1Ryza1/Bewaesserung-System/README.md

# Bewaesserung-System

Zimmerpflanzen feuchtigkeit messen und automatisch gießen.

Wir brauchen
Feuchtigkeitssensor
Microcontroller
Ventil
Behälter
Schlauch
Lampe

Feuchtigkeitssensor erkennt, dass die pflanze gegossen werden muss, anhand der trockenden erde und gibt das Signal and den Microcontroller.
Der Controller öffnet das dazugehörige Ventil.

Wenn der Behälter fast leer ist, leuchtet eine Lampe um zu Signalisieren, dass wasser anchgefüllt werdne muss. Vielleicht auch per push nachricht per Telegrambot
{42C6C1D7-5769-4985-9132-D3B41F0A940E}
{FEBAC813-1F5F-44BB-ADE6-F5729D4DE113}
