1Ryza1/Bewaesserung-System/Arduino_Bewaesserung_Projektdokumentation.docx

PROJEKTDOKUMENTATION

Automatisches Arduino-
Bewässerungssystem für Pflanzen

Sensorbasierte Bewässerung mit OLED-Anzeige, Tanküberwachung,
Menüsteuerung und dauerhaft gespeicherten Statistiken

Projektgruppe | ____________________________
Klasse / Lernfeld | ____________________________
Lehrkraft | ____________________________
Datum | 22.09.2026
Stand | Funktionsfähiger Prototyp

# Inhaltsübersicht

1 Projektübersicht

2 Zielsetzung und Anforderungen

3 Hardware und Komponenten

4 Verdrahtung und Pinbelegung

5 Sensoren und Kalibrierung

6 Funktionsweise der Bewässerung

7 OLED-Menü und Bedienung

8 Statistiken und EEPROM

9 Softwareaufbau

10 Sicherheits- und Fehlerkonzept

11 Testdurchführung und Ergebnisse

12 Grenzen und Erweiterungsmöglichkeiten

13 Fazit

Anhang A Test- und Abnahmecheckliste

Anhang B Zentrale Programmparameter

# 1 Projektübersicht

Im Projekt wurde ein automatisches Bewässerungssystem für Pflanzen auf Basis eines Arduino entwickelt. Das System misst kontinuierlich die Bodenfeuchtigkeit und entscheidet selbstständig, ob gegossen werden muss. Zusätzlich wird überwacht, ob sich ausreichend Wasser im Vorratsbehälter befindet. Ein OLED-Display zeigt Messwerte, Systemstatus und Statistiken an.

Projektkern: Nicht einfach dauerhaft pumpen, sondern dosiert gießen, anschließend warten, erneut messen und nur bei Bedarf eine weitere kleine Wassermenge abgeben.

## 1.1 Aktueller Funktionsumfang

- Bodenfeuchtigkeit als Rohwert und Prozentwert erfassen.
- Bewässerung automatisch ab einem definierten Trockenheitswert starten.
- Pumpe in kurzen 5-Sekunden-Intervallen ansteuern.
- Nach jedem Pumpen 20 Sekunden warten, damit sich das Wasser im Boden verteilen kann.
- Nach der Wartezeit erneut messen und bei Bedarf weiter bewässern.
- Tankfüllstand überwachen und die Pumpe bei leerem Tank sperren.
- Warn-LED bei leerem Tank blinken lassen.
- Drei OLED-Menüseiten über einen Taster umschalten.
- Gießvorgänge, Pumpenrunden und Pumpenlaufzeit dauerhaft im EEPROM speichern.
- Sicherheitslimit von maximal fünf Pumpenrunden pro Bewässerungszyklus verwenden.

# 2 Zielsetzung und Anforderungen

Ziel war die Entwicklung eines funktionsfähigen Prototyps, der eine Pflanze möglichst selbstständig und sicher bewässert. Dabei sollten nicht nur Sensorwerte angezeigt, sondern aus diesen Werten konkrete Aktionen abgeleitet werden.

Punkt | Beschreibung
Automatik | Bewässerung soll ohne manuellen Eingriff starten, sobald die Erde zu trocken ist.
Dosierung | Die Pumpe soll nicht dauerhaft laufen, sondern nur kurze Wassermengen abgeben.
Rückkopplung | Nach dem Gießen wird der neue Bodenwert bewertet, bevor erneut gegossen wird.
Tanküberwachung | Bei leerem Wasserbehälter darf die Pumpe nicht laufen.
Bedienung | Messwerte und Statistiken sollen direkt am Gerät abrufbar sein.
Datenerhalt | Statistiken sollen nach einem Neustart weiterhin vorhanden sein.
Sicherheit | Fehlbedienung und unbegrenztes Pumpen müssen verhindert werden.

# 3 Hardware und Komponenten

Punkt | Beschreibung
Arduino-Board | Steuert Sensoren, Display, LED, Taster und Relais.
SH1106 OLED 128 × 64 | I²C-Display zur Anzeige von Messwerten, Status und Statistiken; Adresse 0x3C.
Bodenfeuchtigkeitssensor | Analoger Sensor zur Bestimmung der Bodenfeuchte; Ausgang AO an A1.
Wasserstandssensor | Analoger Sensor zur Erkennung des Wasserstands im Vorratsbehälter; an A0.
Relaismodul | Schaltet die Pumpe. Das verwendete Modul ist LOW-aktiv.
Wasserpumpe | Fördert Wasser aus dem Tank zur Pflanze.
LED | Optische Warnung bei leerem Tank.
220–330 Ω Widerstand | Vorwiderstand für die Warn-LED.
4-Pin-Taster | Wechselt zwischen den OLED-Menüseiten; elektrisch werden nur zwei gegenüberliegende Kontaktgruppen benötigt.
Schläuche / Wasserbehälter | Führen das Wasser von der Pumpe zur Pflanze.

# 4 Verdrahtung und Pinbelegung

Punkt | Beschreibung
A0 | Wasserstandssensor / Tanksensor
A1 | Bodenfeuchtigkeitssensor (AO)
A4 | OLED SDA
A5 | OLED SCL
D6 | Menü-Taster gegen GND; interner Pull-up aktiv
D7 | Warn-LED über 220–330 Ω Vorwiderstand nach GND
D8 | Relaissteuerung für die Pumpe
5 V | Versorgung der geeigneten Sensor-/OLED-Module gemäß deren Spezifikation
GND | Gemeinsame Masse aller Baugruppen

LED-Anschluss: D7 → 220–330 Ω → Anode der LED (langes Bein) → Kathode (kurzes Bein) → GND. Die LED darf nicht ohne Vorwiderstand direkt zwischen 5 V und GND betrieben werden.

Relaislogik: Das verwendete Relais ist LOW-aktiv: LOW bedeutet Pumpe EIN, HIGH bedeutet Pumpe AUS. Der Sketch setzt den Relaispin deshalb schon beim Start auf HIGH.

## 4.1 Taster mit vier Anschlüssen

Der verwendete Taster besitzt vier Pins, besteht elektrisch jedoch aus zwei Kontaktgruppen. Je zwei Pins sind intern miteinander verbunden. Für die Schaltung werden nur zwei Pins aus unterschiedlichen Kontaktgruppen benötigt. Der Taster wird zwischen D6 und GND angeschlossen. Durch INPUT_PULLUP ist kein externer Pull-up-Widerstand erforderlich.

# 5 Sensoren und Kalibrierung

## 5.1 Bodenfeuchtigkeitssensor

Der Bodenfeuchtigkeitssensor liefert einen Analogwert zwischen ungefähr 0 und 1023. Bei dem verwendeten Sensor gilt: Ein hoher Wert bedeutet trocken, ein niedriger Wert bedeutet feucht.

Messsituation | Rohwert | Interpretation
In trockenes Papier eingewickelt | ca. 1020 | knochentrocken / 0 %
Frische Blumenerde aus dem Sack | ca. 350 | deutlich feucht / Zielbereich
Sehr feuchte Erde im Test | ca. 275 | unterhalb des Zielwerts / Anzeige auf 100 % begrenzt

Für die Anzeige wird der Bereich 1020 → 0 % und 350 → 100 % linear umgerechnet. Werte unter 350 werden auf 100 % begrenzt. Die Prozentanzeige ist daher eine projektbezogene relative Feuchte und keine wissenschaftlich bestimmte volumetrische Bodenfeuchte.

## 5.2 Schaltgrenzen des Bodens

Punkt | Beschreibung
≥ 700 | Boden gilt als zu trocken; ein Bewässerungszyklus wird gestartet.
≤ 350 | Zielwert erreicht; Bewässerung wird beendet.
350–699 | Kein neuer Gießvorgang; Boden gilt als ausreichend feucht.

## 5.3 Tanksensor

Der Tanksensor liefert ebenfalls einen Analogwert. Für die aktuelle Software wird eine Hysterese verwendet: Unter 100 gilt der Tank als leer, über 200 als gefüllt. Zwischen 100 und 200 bleibt der vorherige Zustand erhalten. Dadurch flackert der Tankstatus bei schwankenden Messwerten nicht ständig hin und her.

Die Prozentanzeige des Tanks ist derzeit vorläufig mit 0 → 0 % und 500 → 100 % kalibriert. Für eine genaue Füllstandsanzeige sollten später ein echter Leerwert und ein Wert bei gewünschtem Maximalfüllstand gemessen werden.

# 6 Funktionsweise der Bewässerung

Der Kern des Systems ist eine geschlossene Regelung: Messen → dosiert gießen → warten → erneut messen. Dadurch wird vermieden, dass die Pumpe unnötig lange läuft oder der Boden in einem einzigen Schritt überwässert wird.

1. Boden- und Tankwert werden gemessen.
2. Ist der Tank leer, bleibt die Pumpe gesperrt und die Warn-LED blinkt.
3. Liegt der Bodenwert unter 700, wird nicht gegossen.
4. Liegt der Bodenwert bei 700 oder höher, startet ein Bewässerungszyklus.
5. Die Pumpe läuft 5 Sekunden.
6. Anschließend wartet das System 20 Sekunden, damit sich das Wasser verteilen kann.
7. Der Boden wird erneut gemessen.
8. Bei einem Wert über 350 wird eine weitere 5-Sekunden-Pumpenrunde ausgeführt.
9. Bei einem Wert von 350 oder kleiner wird der Zyklus beendet.
10. Nach maximal fünf Pumpenrunden wird aus Sicherheitsgründen abgebrochen.

## 6.1 Ablaufdiagramm

START
|
Sensoren messen
|
Tank leer? ---- JA ----> Pumpe AUS + LED blinkt
| NEIN
Boden >= 700? -- NEIN --> BEREIT / weiter messen
| JA
Pumpe 5 s AN
|
Pumpe AUS
|
20 s warten
|
Boden erneut messen
|
Boden <= 350? -- JA ---> Ziel erreicht / STOP
| NEIN
Max. 5 Runden erreicht? -- JA --> Sicherheitsstopp
| NEIN
+-----------------------> erneut 5 s gießen

# 7 OLED-Menü und Bedienung

Über den Taster an D6 kann während des Betriebs zwischen drei Menüseiten umgeschaltet werden. Der Taster wird softwareseitig entprellt, damit ein einzelner Tastendruck nicht mehrfach erkannt wird.

## 7.1 Seite 1 – Übersicht

Boden: 63%
Tank: 82%
Pumpe: AUS
---------------------
BEREIT

## 7.2 Seite 2 – Statistik

STATISTIK

Giessen: 4
Pumpen: 9
Laufzeit: 45s

## 7.3 Seite 3 – Rohwerte

ROHWERTE

Boden: 598
Tank: 411
Start:700 Ziel:350

# 8 Statistiken und EEPROM

Die Statistikdaten werden im EEPROM des Arduino gespeichert. Dieser Speicher behält seine Daten auch nach dem Ausschalten. Dadurch gehen die Zähler beim Trennen der Stromversorgung nicht verloren.

Punkt | Beschreibung
Gießvorgänge | Anzahl der vollständigen Bewässerungszyklen, die tatsächlich gestartet wurden.
Pumpenrunden | Anzahl einzelner Pumpenintervalle. Ein Gießvorgang kann aus mehreren Pumpenrunden bestehen.
Pumpenlaufzeit | Aufsummierte Pumpenlaufzeit in Sekunden.

Beispiel: Benötigt ein Bewässerungszyklus drei Pumpenintervalle à fünf Sekunden, erhöht sich „Gießen“ um 1, „Pumpen“ um 3 und die Laufzeit um 15 Sekunden.

EEPROM-Schonung: Die Statistik wird nicht in jeder Programmschleife geschrieben, sondern nur nach relevanten Bewässerungsereignissen. Dadurch werden unnötige Schreibzyklen vermieden.

# 9 Softwareaufbau

Der Sketch ist in einzelne Funktionen gegliedert. Dadurch können Messung, Anzeige, Pumpensteuerung und Statistik unabhängig voneinander nachvollzogen und getestet werden.

Punkt | Beschreibung
mittelwert() | Liest einen Analogeingang zehnmal und bildet einen Mittelwert zur Beruhigung der Messwerte.
bodenMessen() / tankMessen() | Aktualisieren die beiden Sensorwerte.
bodenProzent() / tankProzent() | Rechnen Rohwerte in eine 0–100-%-Anzeige um.
pumpeEin() / pumpeAus() | Kapseln die LOW-aktive Relaislogik.
ledAktualisieren() | Lässt die Warn-LED bei leerem Tank im 500-ms-Takt blinken.
buttonAktualisieren() | Entprellt den Taster und wechselt die Menüseiten.
oledAktualisieren() | Zeichnet die aktuell ausgewählte OLED-Seite.
giessen() | Führt eine einzelne Pumpenrunde von maximal fünf Sekunden aus und überwacht dabei den Tank.
wartenNachGiessen() | Wartet 20 Sekunden, misst dabei regelmäßig und hält LED/Taster weiterhin aktiv.
bewaessern() | Steuert den gesamten Regelzyklus und das Sicherheitslimit.
statistikLaden() / statistikSpeichern() | Lesen und schreiben die persistenten EEPROM-Daten.

## 9.1 Speicherschonung

Das SH1106-OLED benötigt einen großen Bildpuffer im knappen SRAM des Arduino. Eine frühere Programmversion konnte das Display deshalb nicht initialisieren. Die aktuelle Version verwendet für feste Texte das F()-Makro, damit diese Texte im Flash-Speicher statt im SRAM liegen. Dadurch konnte das Display zuverlässig gestartet werden.

# 10 Sicherheits- und Fehlerkonzept

- Tank leer: Pumpe wird gesperrt und die Warn-LED blinkt.
- Tank wird auch während des Pumpens regelmäßig kontrolliert. Wird er leer, stoppt die Pumpe sofort.
- LOW-aktives Relais: HIGH wird als sicherer AUS-Zustand verwendet.
- Beim Programmstart wird der Relaispin möglichst früh auf AUS gesetzt.
- Maximal fünf Pumpenrunden verhindern unbegrenztes Bewässern bei fehlerhaften Messwerten.
- Mittelwertbildung aus zehn Messungen reduziert kurzfristiges Sensorrauschen.
- Hysterese am Tanksensor verhindert häufiges Umschalten an der Leergrenze.

Hardware-Sicherheit: Falls ein LOW-aktives Relais während des Arduino-Resets kurz anzieht, kann ein externer 10-kΩ-Pull-up von D8 nach 5 V den AUS-Pegel zusätzlich hardwareseitig absichern.

# 11 Testdurchführung und Ergebnisse

## 11.1 Sensortest Boden

Zur Kalibrierung wurde der Bodenfeuchtigkeitssensor zunächst in trockenes Papier und anschließend in frische Blumenerde gesteckt. Die Werte unterschieden sich deutlich und ermöglichten die Festlegung sinnvoller Schaltschwellen.

Punkt | Beschreibung
Trockenes Papier | ca. 1020
Frische, leicht feuchte Blumenerde | ca. 350
Sehr feuchte Erde im späteren Test | ca. 275

## 11.2 Bewässerungstest

Ein Test mit 5 Sekunden Pumpenlaufzeit pro Runde verlief erfolgreich. Das System konnte die Pumpe schalten und anschließend den Boden erneut bewerten. Auf dieser Grundlage wurden 5 Sekunden Pumpenlaufzeit und 20 Sekunden Verteilzeit als aktuelle Testparameter übernommen.

## 11.3 Tank-Leer-Test

Beim Test mit leerem Tanksensor lagen die Werte ungefähr bei 3 bis 4. Das System erkannte „Wasser: NEIN“ und zeigte 0 % Tankfüllstand an. Nach Korrektur der Relaislogik blieb die Pumpe im Leerzustand zuverlässig aus.

## 11.4 OLED- und Speichertest

Der I²C-Scanner erkannte das OLED zuverlässig unter Adresse 0x3C. Nach der SRAM-Optimierung mit F()-Strings konnte das SH1106-Display zusammen mit dem vollständigen Programm betrieben werden. Die Statistik startet bei einem neuen EEPROM-Datensatz mit Nullwerten und bleibt nach Neustarts erhalten.

# 12 Grenzen und Erweiterungsmöglichkeiten

- Exakte Tankkalibrierung mit realem Leer- und Vollwert statt der vorläufigen 0–500-Skalierung.
- Sensorfehler erkennen, z. B. dauerhaft 0/1023 oder keine Reaktion auf Bewässerung.
- Fördermenge der Pumpe in ml/s bestimmen und die abgegebene Wassermenge statistisch erfassen.
- Langdruck auf den Menütaster zum Zurücksetzen der Statistik.
- Balkenanzeigen für Boden- und Tankfüllstand auf dem OLED.
- Erkennung „Bewässerung ohne Wirkung“, wenn der Bodenwert nach mehreren Runden kaum sinkt.
- Umstieg auf ESP32 für WLAN, Weboberfläche oder Telegram-/Push-Benachrichtigungen.
- Zeitstempel und Tagesstatistik mit Echtzeituhr (RTC), falls Tages-/Wochenverläufe benötigt werden.

Eine direkte Telegram-Benachrichtigung ist mit dem aktuellen Arduino ohne Netzwerkmodul nicht möglich. Dafür wäre beispielsweise ein ESP32 mit WLAN oder ein zusätzliches Netzwerkmodul erforderlich.

# 13 Fazit

Der Prototyp erfüllt die wesentlichen Projektziele. Er misst die Bodenfeuchtigkeit, bewässert bedarfsgerecht in kleinen Intervallen, kontrolliert den Wasserbehälter und stellt alle wichtigen Informationen lokal auf einem OLED dar. Durch die Rückmessung nach jedem Gießvorgang reagiert das System auf den tatsächlichen Zustand der Erde statt nur nach einer festen Zeit zu pumpen.

Mit der Warn-LED, der Tank-Sperre, dem Sicherheitslimit, der LOW-aktiven Relaislogik und der dauerhaften Statistik verfügt das System bereits über mehrere Funktionen, die über eine einfache Demonstrationsschaltung hinausgehen. Für eine spätere Weiterentwicklung bieten sich insbesondere eine genauere Tankkalibrierung, eine Sensorfehlererkennung und eine netzwerkfähige Plattform an.

# Anhang A – Test- und Abnahmecheckliste

Prüfung | Sollverhalten | OK
OLED | Beim Start erscheint die Anzeige und I²C-Adresse 0x3C wird erkannt. | ☐
Boden trocken | Bei Rohwert ≥700 wird ein Bewässerungszyklus gestartet. | ☐
Boden feucht | Bei Rohwert ≤350 wird nicht weiter gegossen. | ☐
Pumpe | Relais D8 ist LOW-aktiv: LOW = AN, HIGH = AUS. | ☐
Tank gefüllt | Pumpe darf starten, wenn Wasser vorhanden ist. | ☐
Tank leer | Pumpe bleibt aus / stoppt sofort; LED D7 blinkt. | ☐
Taster | Kurzer Druck auf D6 wechselt genau eine Menüseiten weiter. | ☐
Statistik | Gießvorgang, Pumpenrunden und Laufzeit werden korrekt erhöht. | ☐
EEPROM | Statistik bleibt nach Aus- und Einschalten erhalten. | ☐
Sicherheitslimit | Nach maximal fünf Pumpenrunden wird abgebrochen. | ☐

# Anhang B – Zentrale Programmparameter

Parameter | Wert | Bedeutung | Anpassung
SOIL_TROCKEN | 1020 | 0 % Bodenfeuchte | nach Kalibrierung
SOIL_NASS | 350 | 100 % / Zielreferenz | nach Kalibrierung
SOIL_START | 700 | Start Bewässerung | pflanzenabhängig
SOIL_ZIEL | 350 | Bewässerung beenden | pflanzenabhängig
TANK_MIN | 0 | 0 % Tank | noch exakt kalibrieren
TANK_MAX | 500 | 100 % Tank | noch exakt kalibrieren
TANK_LEER | 100 | Tank gilt als leer | nach Tanktest
TANK_WASSER | 200 | Wasser sicher vorhanden | nach Tanktest
PUMP_DAUER | 5000 ms | Pumpenintervall | nach Fördermenge
WARTEZEIT | 20000 ms | Verteilzeit des Wassers | nach Bodentest
MAX_RUNDEN | 5 | Sicherheitslimit | nur bewusst ändern
BUTTON_PIN | D6 | Menütaster | fest verdrahtet
LED_PIN | D7 | Tankwarnung | fest verdrahtet
RELAY_PIN | D8 | Pumpenrelais | fest verdrahtet
