1Ryza1/Bewaesserung-System/(commit log)

2026-10-27 okumentation fuer Arduino-Pumpenschutz anlegen
2026-10-27 Arduino-Pumpenschutz mit Anleitung und Pruefbericht ergaenzen
2026-11-03 Messdaten auswerten und OLED-Verlauf ergänzen
